DougTownsend/ece212-project2/kicad/p2_schematic.pdf

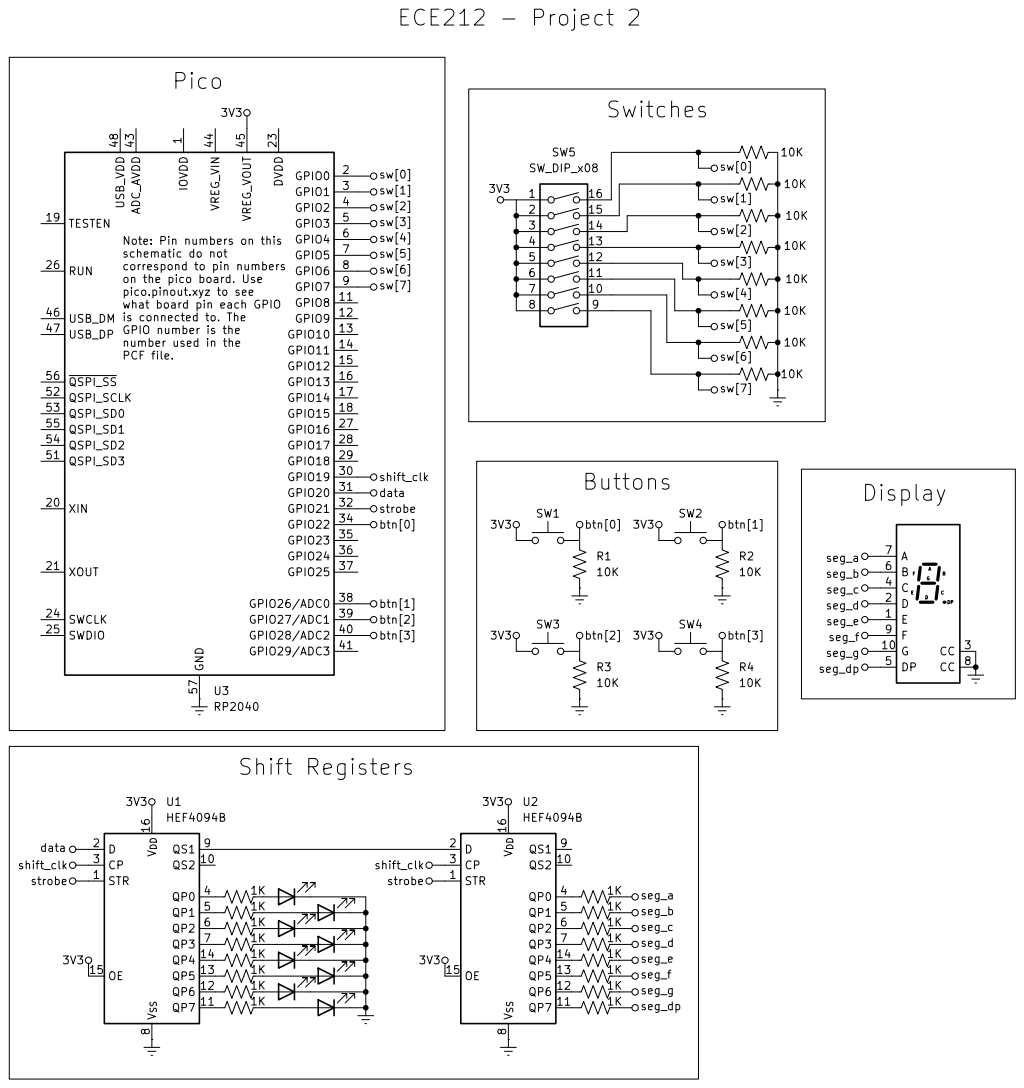
[picture p25: page 1]
