DougTownsend/ece212-project2/kicad/project2.kicad_sch

## KiCad design kicad/project2.kicad_sch (2026-10-09)

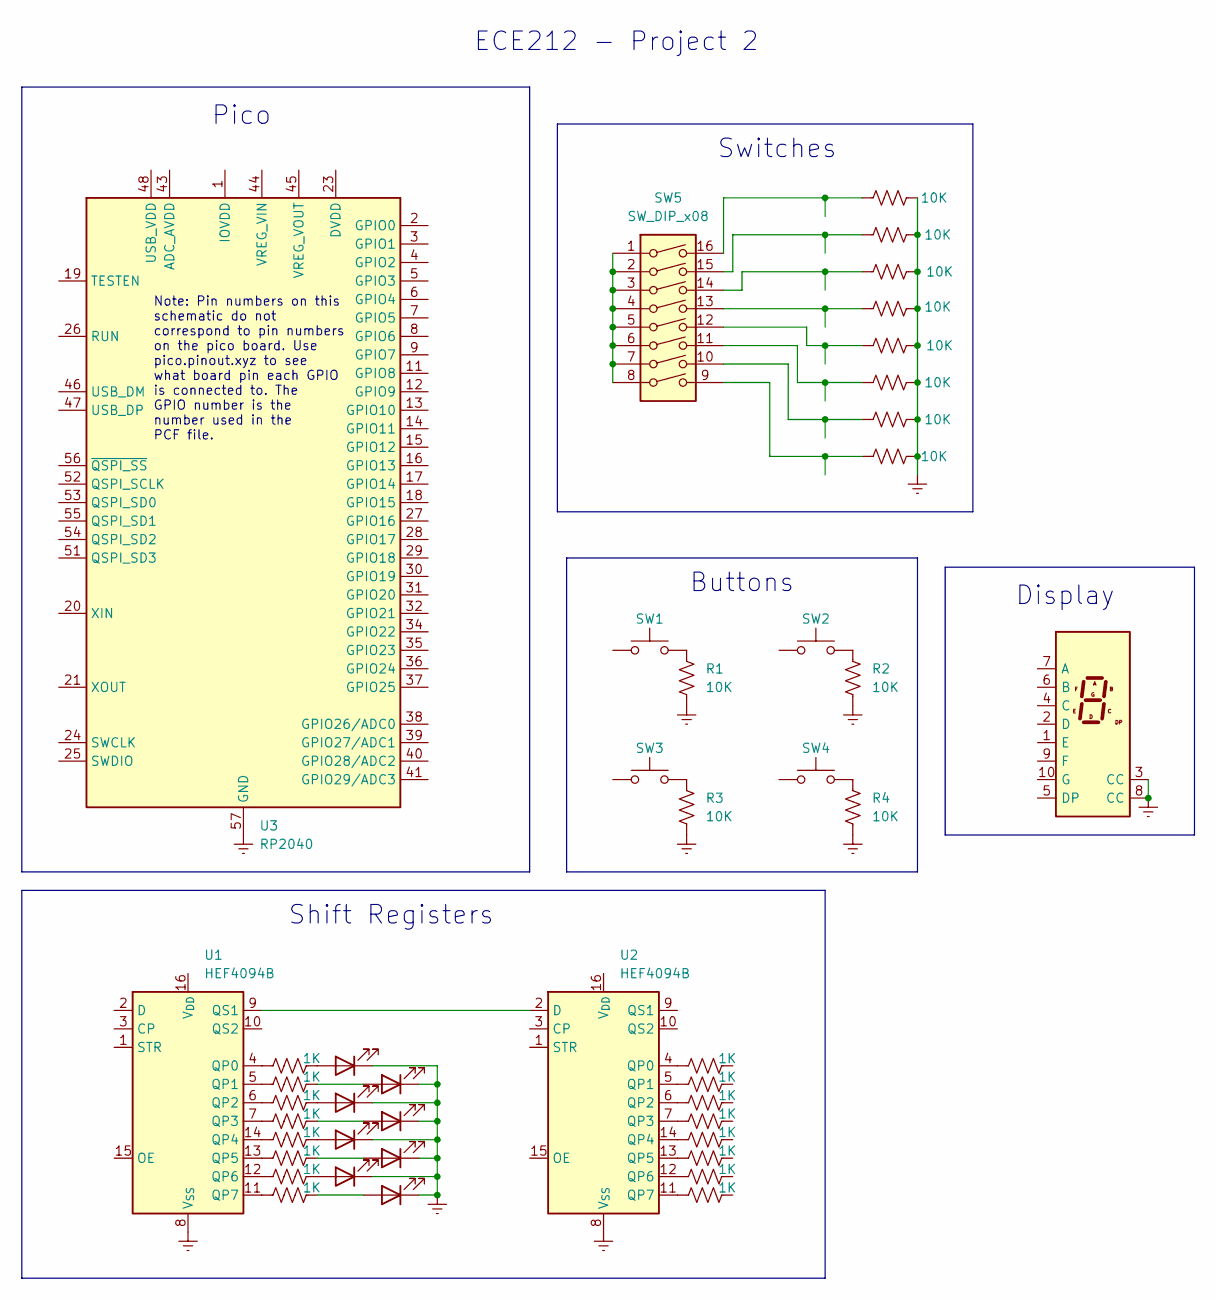
[picture p26: schematic project2.kicad_sch]

Parts:
D1, D2, D3, D4, D5, D6, D7, D8: LED
R1, R2, R3, R4, R21, R22, R23, R24, R25, R26, R27, R28: 10K; R_Array_SIP4
R5, R6, R7, R8, R9, R10, R11, R12, R13, R14, R15, R16, R17, R18, R19, R20: 1K; R_Array_SIP4
SW1, SW2, SW3, SW4: SW_Push; Nidec_Copal_CAS-120A
SW5: SW_DIP_x08
U1, U2: HEF4094B; SOIC-14_3.9x8.7mm_P1.27mm
U3: RP2040; QFN-56-1EP_7x7mm_P0.4mm_EP3.2x3.2mm
U5: KCSC02-107

Connections:
GNDREF: D1.1 (K), D2.1 (K), D3.1 (K), D4.1 (K), D5.1 (K), D6.1 (K), D7.1 (K), D8.1 (K), R1.2, R2.2, R3.2, R4.2, R21.2, R22.2, R23.2, R24.2, R25.2, R26.2, R27.2, R28.2, U1.8 (V_{SS}), U2.8 (V_{SS}), U3.57 (GND), U5.3 (CC), U5.8 (CC)
unnamed: D1.2 (A), R5.2
unnamed: D2.2 (A), R6.2
unnamed: D3.2 (A), R7.2
unnamed: D4.2 (A), R8.2
unnamed: D5.2 (A), R9.2
unnamed: D6.2 (A), R10.2
unnamed: D7.2 (A), R11.2
unnamed: D8.2 (A), R12.2
unnamed: R1.1, SW1.2
unnamed: R2.1, SW2.2
unnamed: R3.1, SW3.2
unnamed: R4.1, SW4.2
unnamed: R5.1, U1.4 (QP0)
unnamed: R6.1, U1.5 (QP1)
unnamed: R7.1, U1.6 (QP2)
unnamed: R8.1, U1.7 (QP3)
unnamed: R9.1, U1.14 (QP4)
unnamed: R10.1, U1.13 (QP5)
unnamed: R11.1, U1.12 (QP6)
unnamed: R12.1, U1.11 (QP7)
unnamed: R13.1, U2.4 (QP0)
unnamed: R14.1, U2.5 (QP1)
unnamed: R15.1, U2.6 (QP2)
unnamed: R16.1, U2.7 (QP3)
unnamed: R17.1, U2.14 (QP4)
unnamed: R18.1, U2.13 (QP5)
unnamed: R19.1, U2.12 (QP6)
unnamed: R20.1, U2.11 (QP7)
unnamed: R21.1, SW5.16
unnamed: R22.1, SW5.15
unnamed: R23.1, SW5.14
unnamed: R24.1, SW5.13
unnamed: R25.1, SW5.12
unnamed: R26.1, SW5.11
unnamed: R27.1, SW5.10
unnamed: R28.1, SW5.9
unnamed: SW5.1, SW5.2, SW5.3, SW5.4, SW5.5, SW5.6, SW5.7, SW5.8
unnamed: U1.9 (QS1), U2.2 (D)
unnamed: U3.1 (IOVDD), U3.10 (IOVDD), U3.22 (IOVDD), U3.33 (IOVDD), U3.42 (IOVDD), U3.49 (IOVDD)
unnamed: U3.23 (DVDD), U3.50 (DVDD)

Notes on the sheet:
Pico
Buttons
Shift Registers
ECE212 - Project 2
Switches
Display
Note: Pin numbers on this schematic do not correspond to pin numbers on the pico board. Use pico.pinout.xyz to see what board pin each GPIO is connected to. The GPIO number is the number used in the PCF file.
