DougTownsend/ece212-project2/fpga_enigma/negate.v

module negate(
    input en,
    input [3:0] in,
    output reg [3:0] out
);
    /*
    Applies 2s complement negation.
    If en is low, just pass in through to out unchanged.
    */
    //Do not modify above this line

endmodule
