DougTownsend/ece212-project2/fpga_enigma/ones_comp_add.v

module ones_comp_add(
    input [3:0] a,
    input [3:0] b,
    output reg [3:0] out
);
    /*
    Applies ones complement addition. Add a and b, and then add the
    carry out to the ones bit of the result. The carry can be
    accessed by adding a and b and putting the result in a 5 bit reg.
    */
    //Do not modify above this line


endmodule
