DougTownsend/ece212-project2/pico_enigma/swap.v

module swap(
    input en,
    input [3:0] a,
    input [3:0] b,
    output reg [3:0] x,
    output reg [3:0] y
);
    /*
    When en is 0, x = a and y = b
    when en is 1, x = b and y = a
    */
    //Do not modify above this line

endmodule
