DougTownsend/ece212-project2/fpga_enigma/test/test_6_0_sevseg_disp_tb.v

module test_6_0_sevseg_disp_tb();
    // Test 6.0: every digit with the decimal point off.
    reg [3:0] in;
    reg dp;
    wire [7:0] segs;
    integer outfile;

    sevseg_disp uut(.in(in), .dp(dp), .segs(segs));

    initial begin
        $dumpvars(0, test_6_0_sevseg_disp_tb);
        outfile = $fopen("test/results/test_6_0_sevseg_disp.txt", "w");
        $fdisplay(outfile, "time,in,dp,segs");
        // Writes a line to the file every time one of the signals changes
        $fmonitor(outfile, "%0t,%h,%b,%b", $time, in, dp, segs);
        #0;  // let every always @(*) block start before the inputs change

        dp = 0; in = 4'h0; #10;
        dp = 0; in = 4'h1; #10;
        dp = 0; in = 4'h2; #10;
        dp = 0; in = 4'h3; #10;
        dp = 0; in = 4'h4; #10;
        dp = 0; in = 4'h5; #10;
        dp = 0; in = 4'h6; #10;
        dp = 0; in = 4'h7; #10;
        dp = 0; in = 4'h8; #10;
        dp = 0; in = 4'h9; #10;
        dp = 0; in = 4'hA; #10;
        dp = 0; in = 4'hB; #10;
        dp = 0; in = 4'hC; #10;
        dp = 0; in = 4'hD; #10;
        dp = 0; in = 4'hE; #10;
        dp = 0; in = 4'hF; #10;
        $finish;
    end
endmodule
