DougTownsend/ece212-project2/pico_enigma/test/test_2_2_sbox_tb.v

module test_2_2_sbox_tb();
    // Test 2.2: en and in change one at a time.
    reg en;
    reg [3:0] in;
    wire [3:0] out;
    integer outfile;

    sbox uut(.en(en), .in(in), .out(out));

    initial begin
        $dumpvars(0, test_2_2_sbox_tb);
        outfile = $fopen("test/results/test_2_2_sbox.txt", "w");
        $fdisplay(outfile, "time,en,in,out");
        // Writes a line to the file every time one of the signals changes
        $fmonitor(outfile, "%0t,%b,%0d,%0d", $time, en, in, out);
        #0;  // let every always @(*) block start before the inputs change

        en = 0; in = 6; #10;
        en = 1; #10;
        en = 0; #10;
        in = 11; #10;
        en = 1; #10;
        in = 2; #10;
        en = 0; #10;
        in = 9; #10;
        en = 1; #10;
        in = 15; #10;
        en = 0; #10;
        in = 0; #10;
        en = 1; #10;
        in = 13; #10;
        $finish;
    end
endmodule
